oskarvh/nanoFunctionGenerator/README.md

# nanoFunctionGenerator
Arbitrary function generator using the RP2040
