oskarvh/nanoFunctionGenerator/hardware/nanoFunctionGenerator/nanoFunctionGenerator.kicad_pcb

## KiCad design hardware/nanoFunctionGenerator/nanoFunctionGenerator.kicad_pcb (2025-07-07)

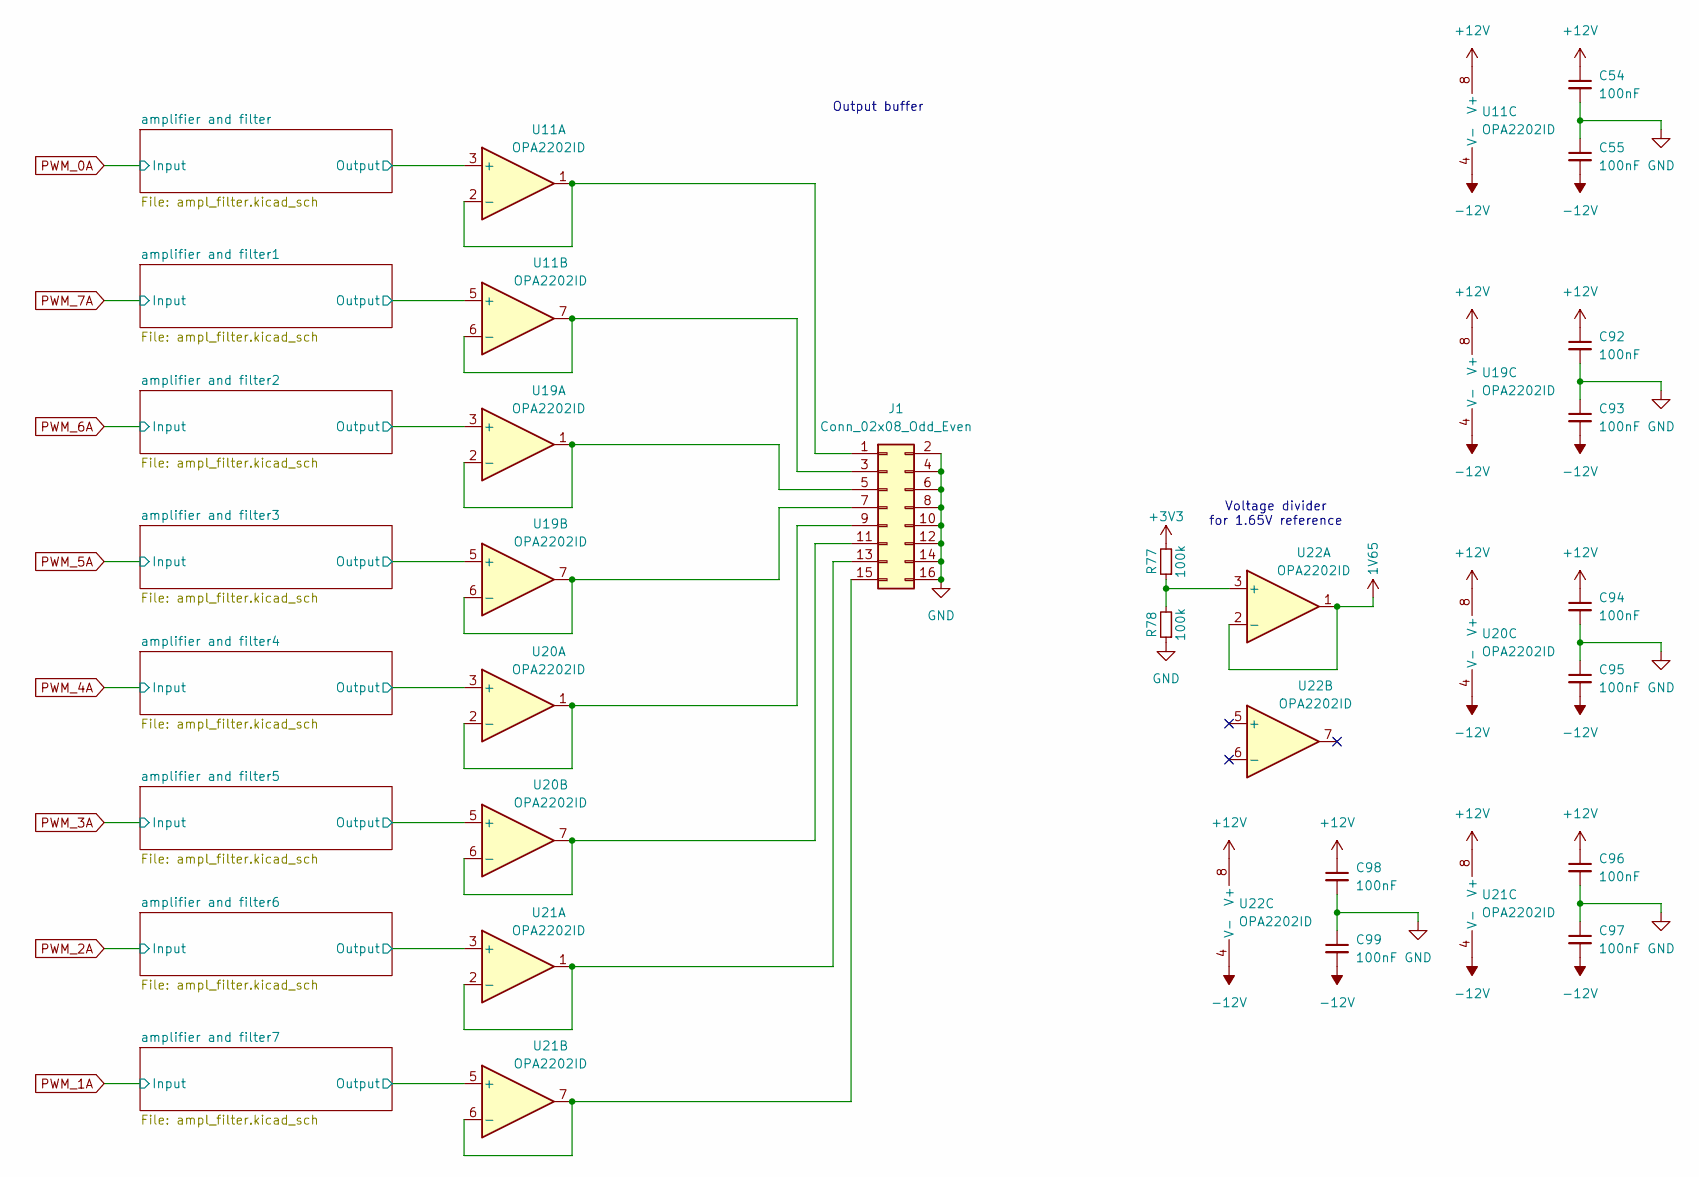
[picture p1: schematic AnalogFrontEnd.kicad_sch]

Parts:
C54, C55, C92, C93, C94, C95, C96, C97, C98, C99: 100nF; C_0402_1005Metric
J1: Conn_02x08_Odd_Even; PinHeader_2x08_P2.54mm_Vertical
R77, R78: 100k; R_0402_1005Metric
U11, U19, U20, U21, U22: OPA2202ID; SOIC-8_3.9x4.9mm_P1.27mm

Connections:
1V65: U22.1, U22.2 (-); also elsewhere on the board
+3V3: R77.2; also elsewhere on the board
+12V: C54.1, C92.1, C94.1, C96.1, C98.1, U11.8 (V+), U19.8 (V+), U20.8 (V+), U21.8 (V+), U22.8 (V+); also elsewhere on the board
-12V: C55.2, C93.2, C95.2, C97.2, C99.2, U11.4 (V-), U19.4 (V-), U20.4 (V-), U21.4 (V-), U22.4 (V-); also elsewhere on the board
/AnalogFrontEnd/amplifier and filter1/Output: U11.5 (+); also elsewhere on the board
/AnalogFrontEnd/amplifier and filter2/Output: U19.3 (+); also elsewhere on the board
/AnalogFrontEnd/amplifier and filter3/Output: U19.5 (+); also elsewhere on the board
/AnalogFrontEnd/amplifier and filter4/Output: U20.3 (+); also elsewhere on the board
/AnalogFrontEnd/amplifier and filter5/Output: U20.5 (+); also elsewhere on the board
/AnalogFrontEnd/amplifier and filter6/Output: U21.3 (+); also elsewhere on the board
/AnalogFrontEnd/amplifier and filter7/Output: U21.5 (+); also elsewhere on the board
/AnalogFrontEnd/amplifier and filter/Output: U11.3 (+); also elsewhere on the board
GND: C54.2, C55.1, C92.2, C93.1, C94.2, C95.1, C96.2, C97.1, C98.2, C99.1, J1.2, J1.4, J1.6, J1.8, J1.10, J1.12, J1.14, J1.16, R78.1; also elsewhere on the board
unnamed: J1.1, U11.1, U11.2 (-)
unnamed: J1.3, U11.6 (-), U11.7
unnamed: J1.5, U19.1, U19.2 (-)
unnamed: J1.7, U19.6 (-), U19.7
unnamed: J1.9, U20.1, U20.2 (-)
unnamed: J1.11, U20.6 (-), U20.7
unnamed: J1.13, U21.1, U21.2 (-)
unnamed: J1.15, U21.6 (-), U21.7
unnamed: R77.1, R78.2, U22.3 (+)

Notes on the sheet:
Voltage divider for 1.65V reference
Output buffer

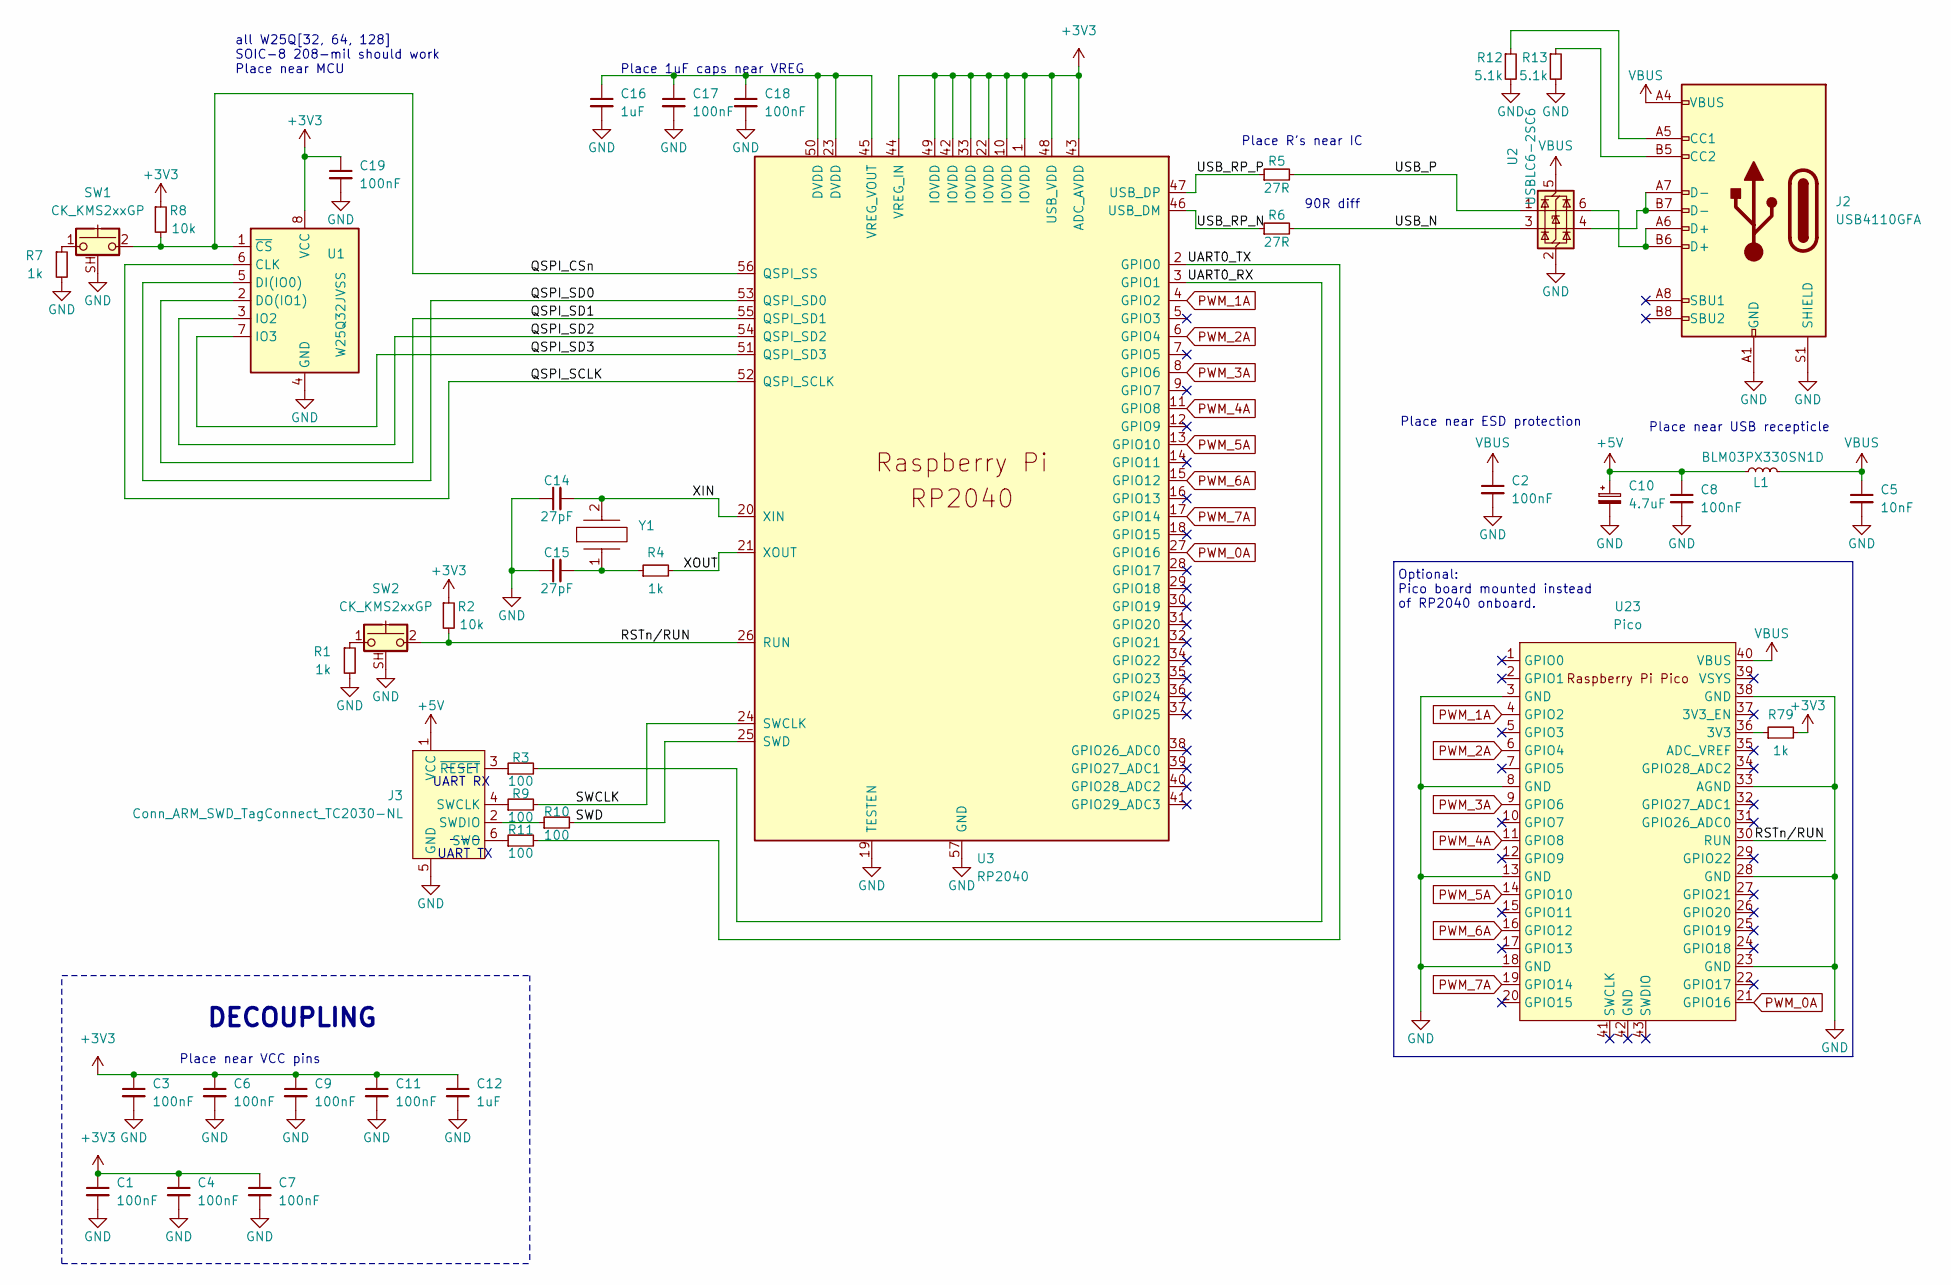
[picture p2: schematic mcu.kicad_sch]

Parts:
C1, C2, C3, C4, C6, C7, C8, C9, C11, C17, C18, C19: 100nF; C_0402_1005Metric; LCSC C1525
C5: 10nF; C_0402_1005Metric; LCSC C1525
C10: 4.7uF; C_Elec_4x5.4; Part Number 865080640004
C12, C16: 1uF; C_0402_1005Metric; LCSC C52923
C14, C15: 27pF; C_0402_1005Metric; LCSC C126504
J2: USB4110GFA; USB4110-GF-A_GCT
J3: Conn_ARM_SWD_TagConnect_TC2030-NL; Tag-Connect_TC2030-IDC-NL_2x03_P1.27mm_Vertical
L1: BLM03PX330SN1D; L_0603_1608Metric
R1, R7: 1k; R_0402_1005Metric; LCSC C279981
R2, R8: 10k; R_0402_1005Metric; LCSC C140214
R3, R9, R10, R11: 100; R_0402_1005Metric; LCSC C279981
R4, R79: 1k; R_0402_1005Metric; LCSC C11702
R5, R6: 27R; R_0402_1005Metric; LCSC C25100
R12, R13: 5.1k; R_0402_1005Metric; LCSC C279981
SW1, SW2: CK_KMS2xxGP; SW_SPST_CK_KMS2xxGP
U1: W25Q32JVSS; SOIC-8_5.23x5.23mm_P1.27mm
U2: USBLC6-2SC6; SOT-23-6
U3: RP2040; QFN-56-1EP_7x7mm_P0.4mm_EP3.2x3.2mm_ThermalVias; LCSC C2040
U23: Pico; RPi_Pico_SMD_TH
Y1: 445I23D12M00000; 445I23D12M00000_CTS-L; Mouser Part Number 774-445I23D12M00000

Connections:
+3V3: C1.1, C3.1, C4.1, C6.1, C7.1, C9.1, C11.1, C12.1, C19.1, R2.1, R8.1, R79.2, U1.8 (VCC), U3.1 (IOVDD), U3.10 (IOVDD), U3.22 (IOVDD), U3.33 (IOVDD), U3.42 (IOVDD), U3.43 (ADC_AVDD), U3.44 (VREG_IN), U3.48 (USB_VDD), U3.49 (IOVDD); also elsewhere on the board
+5V: C8.1, C10.1, J3.1 (VCC), L1.1; also elsewhere on the board
/mcu/QSPI_CSn: R8.2, SW1.2, U1.1 (~CS), U3.56 (QSPI_SS)
/mcu/QSPI_SCLK: U1.6 (CLK), U3.52 (QSPI_SCLK)
/mcu/QSPI_SD0: U1.5 (DI(IO0)), U3.53 (QSPI_SD0)
/mcu/QSPI_SD1: U1.2 (DO(IO1)), U3.55 (QSPI_SD1)
/mcu/QSPI_SD2: U1.3 (IO2), U3.54 (QSPI_SD2)
/mcu/QSPI_SD3: U1.7 (IO3), U3.51 (QSPI_SD3)
/mcu/RSTn/RUN: R2.2, SW2.2, U3.26 (RUN), U23.30 (RUN)
/mcu/SWCLK: R9.2, U3.24 (SWCLK)
/mcu/SWD: R10.2, U3.25 (SWD)
/mcu/UART0_RX: R3.2, U3.3 (GPIO1)
/mcu/UART0_TX: R11.2, U3.2 (GPIO0)
/mcu/USB_N: R6.2, U2.3 (I/O2)
/mcu/USB_P: R5.2, U2.1 (I/O1)
/mcu/USB_RP_N: R6.1, U3.46 (USB_DM)
/mcu/USB_RP_P: R5.1, U3.47 (USB_DP)
/mcu/XIN: C14.2, U3.20 (XIN), Y1.2
/mcu/XOUT: R4.2, U3.21 (XOUT)
GND: C1.2, C2.2, C3.2, C4.2, C5.2, C6.2, C7.2, C8.2, C9.2, C10.2, C11.2, C12.2, C14.1, C15.1, C16.2, C17.2, C18.2, C19.2, J2.A1 (GND), J2.A12 (GND), J2.B1 (GND), J2.B12 (GND), J2.S1 (SHIELD), J3.5 (GND), R1.2, R7.2, R12.2, R13.2, SW1.SH (B), SW2.SH (B), U1.4 (GND), U2.2 (GND), U3.19 (TESTEN), U3.57 (GND), U23.3 (GND), U23.8 (GND), U23.13 (GND), U23.18 (GND), U23.23 (GND), U23.28 (GND), U23.33 (AGND), U23.38 (GND); also elsewhere on the board
unnamed: C15.2, R4.1, Y1.1
unnamed: J2.A5 (CC1), R12.1
unnamed: J2.B5 (CC2), R13.1
unnamed: J2.A6 (D+), J2.B6 (D+), U2.6 (I/O1)
unnamed: J2.A7 (D-), J2.B7 (D-), U2.4 (I/O2)
unnamed: J3.4 (SWCLK), R9.1
unnamed: J3.2 (SWDIO), R10.1
unnamed: J3.6 (SWO), R11.1
unnamed: J3.3 (~RESET), R3.1
unnamed: R1.1, SW2.1
unnamed: R7.1, SW1.1
unnamed: C16.1, C17.1, C18.1, U3.23 (DVDD), U3.45 (VREG_VOUT), U3.50 (DVDD)
unnamed: R79.1, U23.36 (3V3)
PWM_0A: U3.27 (GPIO16), U23.21 (GPIO16); also elsewhere on the board
PWM_1A: U3.4 (GPIO2), U23.4 (GPIO2); also elsewhere on the board
PWM_2A: U3.6 (GPIO4), U23.6 (GPIO4); also elsewhere on the board
PWM_3A: U3.8 (GPIO6), U23.9 (GPIO6); also elsewhere on the board
PWM_4A: U3.11 (GPIO8), U23.11 (GPIO8); also elsewhere on the board
PWM_5A: U3.13 (GPIO10), U23.14 (GPIO10); also elsewhere on the board
PWM_6A: U3.15 (GPIO12), U23.16 (GPIO12); also elsewhere on the board
PWM_7A: U3.17 (GPIO14), U23.19 (GPIO14); also elsewhere on the board
VBUS: C2.1, C5.1, J2.A4 (VBUS), J2.A9 (VBUS), J2.B4 (VBUS), J2.B9 (VBUS), L1.2, U2.5 (VBUS), U23.40 (VBUS)

Notes on the sheet:
Place near USB recepticle
Place R's near IC
--- UART TX
Optional: Pico board mounted instead of RP2040 onboard.
--- UART RX
Place near ESD protection
all W25Q[32, 64, 128] SOIC-8 208-mil should work Place near MCU
Place 1uF caps near VREG
Place near VCC pins
90R diff
DECOUPLING

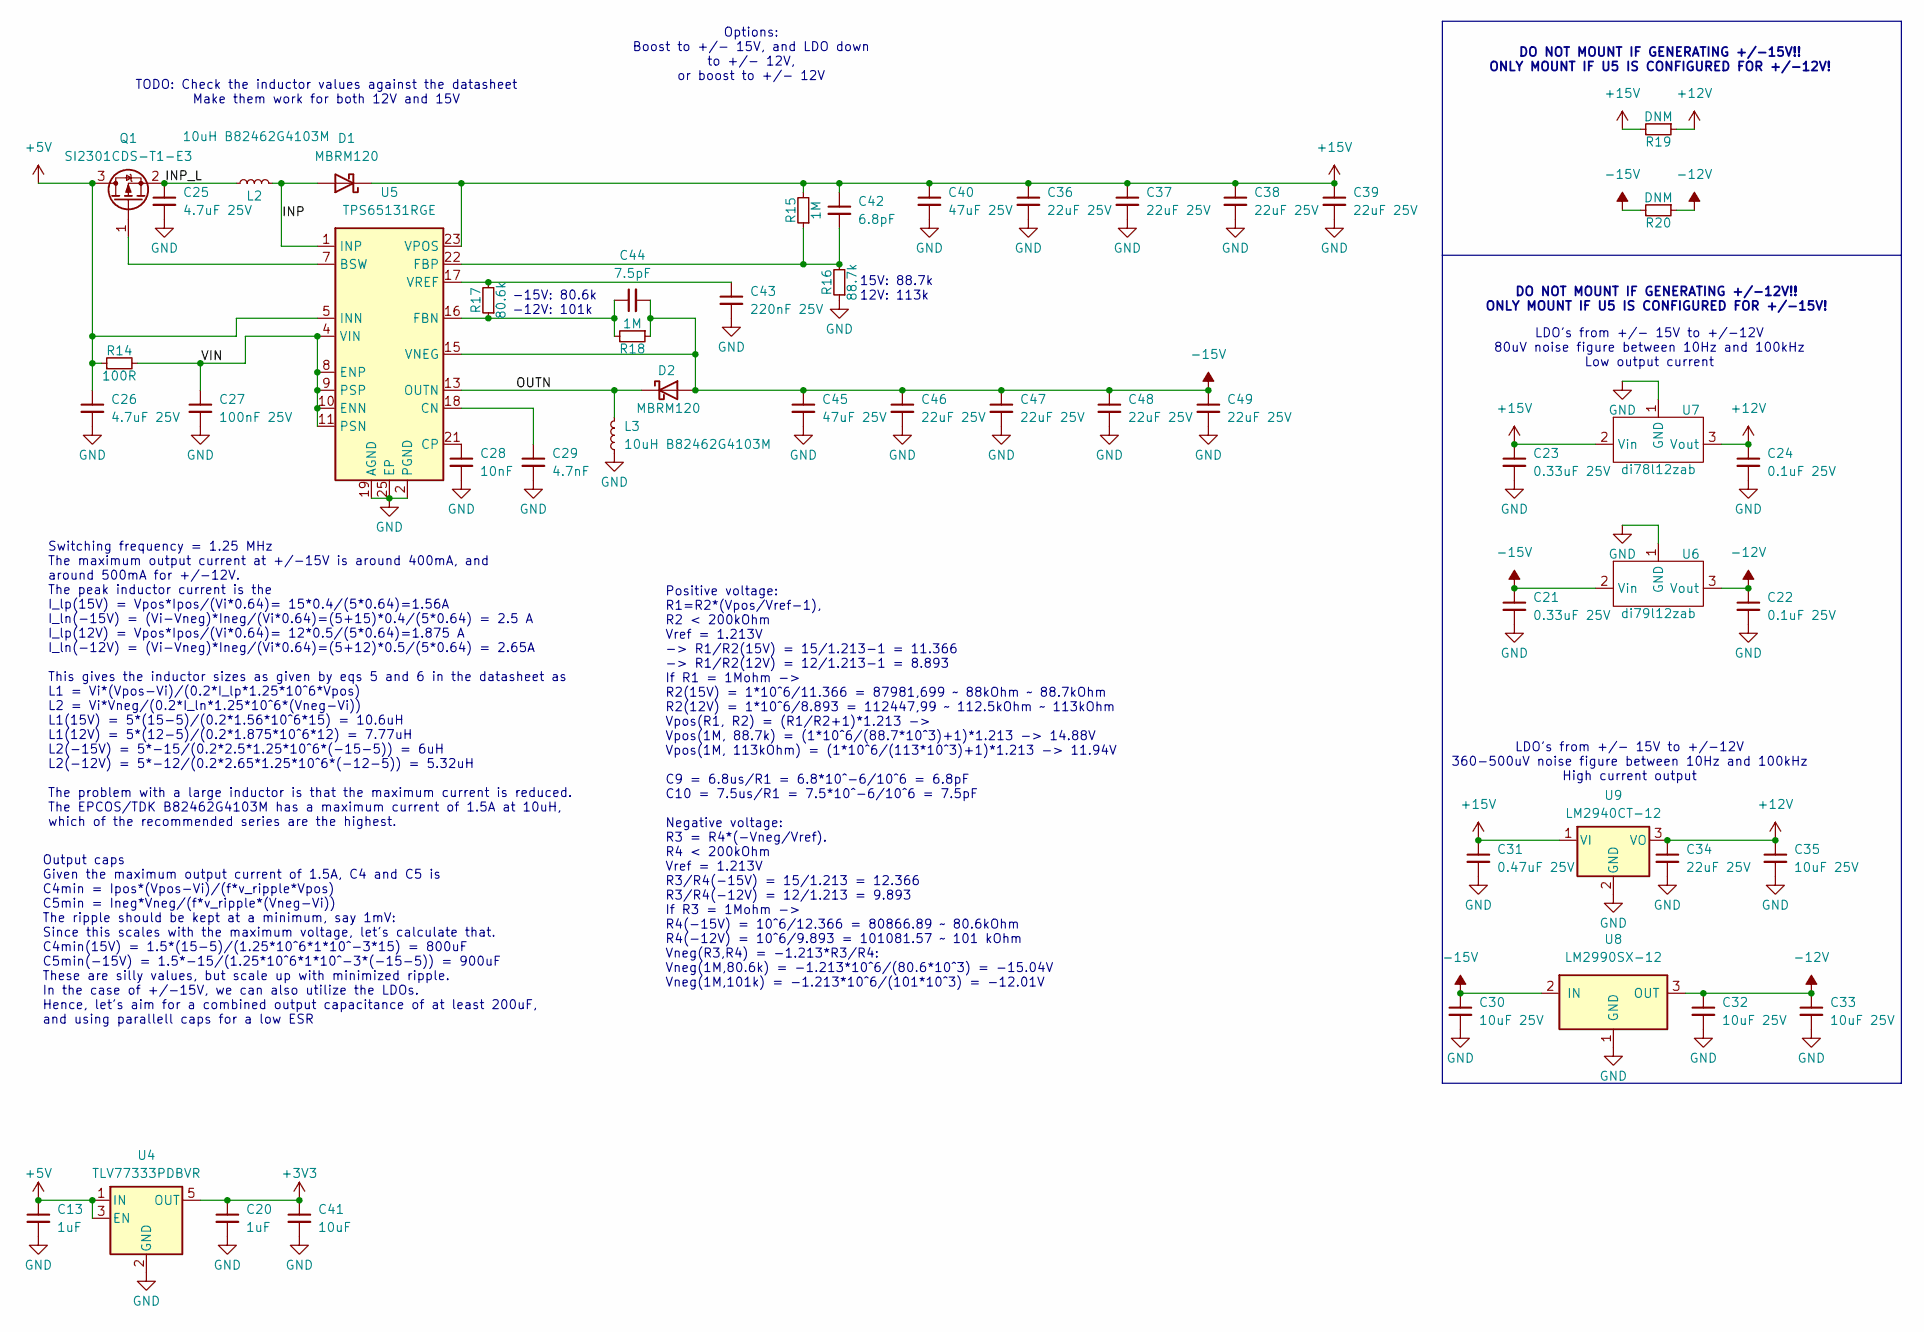
[picture p3: schematic power.kicad_sch]

Parts:
C13, C20: 1uF; C_0603_1608Metric
C21, C23: 0.33uF 25V; C_0603_1608Metric
C22, C24: 0.1uF 25V; C_0603_1608Metric
C25, C26: 4.7uF 25V; C_0805_2012Metric
C27: 100nF 25V; C_0402_1005Metric
C28: 10nF; C_0402_1005Metric
C29: 4.7nF; C_0402_1005Metric
C30, C32, C33, C35: 10uF 25V; C_0805_2012Metric
C31: 0.47uF 25V; C_0603_1608Metric
C34, C36, C37, C38, C39, C46, C47, C48, C49: 22uF 25V; C_0805_2012Metric
C40, C45: 47uF 25V; C_1206_3216Metric
C41: 10uF; C_0603_1608Metric
C42: 6.8pF; C_0402_1005Metric
C43: 220nF 25V; C_0402_1005Metric
C44: 7.5pF; C_0402_1005Metric
D1, D2: MBRM120
L2, L3: 10uH B82462G4103M; L_Vishay_IHLP-2525
Q1: SI2301CDS-T1-E3; SOT-23
R14: 100R; R_0402_1005Metric
R15, R18: 1M; R_0402_1005Metric
R16: 88.7k; R_0402_1005Metric
R17: 80.6k; R_0402_1005Metric
R19, R20: DNM; R_0402_1005Metric
U4: TLV77333PDBVR; SOT-23-5
U5: TPS65131RGE; VQFN-24-1EP_4x4mm_P0.5mm_EP2.45x2.45mm_ThermalVias
U6: di79l12zab; TO-92
U7: di78l12zab; TO-92
U8: LM2990SX-12; TO-220-3_no_hole
U9: LM2940CT-12; TO-220-3_no_hole

Connections:
+3V3: C20.1, C41.1, U4.5 (OUT); also elsewhere on the board
+5V: C13.1, C26.1, Q1.3 (D), R14.1, U4.1 (IN), U4.3 (EN), U5.5 (INN), U5.6 (INN); also elsewhere on the board
+12V: C24.1, C34.1, C35.1, R19.1, U7.3 (Vout), U9.3 (VO); also elsewhere on the board
+15V: C23.1, C31.1, C36.1, C37.1, C38.1, C39.1, C40.1, C42.1, D1.1 (K), R15.2, R19.2, U5.23 (VPOS), U7.2 (Vin), U9.1 (VI)
-12V: C22.1, C32.1, C33.1, R20.1, U6.3 (Vout), U8.3 (OUT); also elsewhere on the board
-15V: C21.1, C30.1, C44.2, C45.1, C46.1, C47.1, C48.1, C49.1, D2.2 (A), R18.1, R20.2, U5.15 (VNEG), U6.2 (Vin), U8.2 (IN)
/power/INP: D1.2 (A), L2.2, U5.1 (INP), U5.24 (INP)
/power/INP_L: C25.1, L2.1, Q1.2 (S)
/power/OUTN: D2.1 (K), L3.2, U5.13 (OUTN), U5.14 (OUTN)
/power/VIN: C27.1, R14.2, U5.4 (VIN), U5.8 (ENP), U5.9 (PSP), U5.10 (ENN), U5.11 (PSN)
GND: C13.2, C20.2, C21.2, C22.2, C23.2, C24.2, C25.2, C26.2, C27.2, C28.2, C29.2, C30.2, C31.2, C32.2, C33.2, C34.2, C35.2, C36.2, C37.2, C38.2, C39.2, C40.2, C41.2, C43.2, C45.2, C46.2, C47.2, C48.2, C49.2, L3.1, R16.1, U4.2 (GND), U5.2 (PGND), U5.3 (PGND), U5.19 (AGND), U5.25 (EP), U6.1 (GND), U7.1 (GND), U8.1 (GND), U9.2 (GND); also elsewhere on the board
unnamed: Q1.1 (G), U5.7 (BSW)
unnamed: C29.1, U5.18 (CN)
unnamed: C28.1, U5.21 (CP)
unnamed: C44.1, R17.1, R18.2, U5.16 (FBN)
unnamed: C42.2, R15.1, R16.2, U5.22 (FBP)
unnamed: C43.1, R17.2, U5.17 (VREF)

Notes on the sheet:
Switching frequency = 1.25 MHz The maximum output current at +/-15V is around 400mA, and around 500mA for +/-12V. The peak inductor current is the I_lp(15V) = Vpos*Ipos/(Vi*0.64)= 15*0.4/(5*0.64)=1.56A I_ln(-15V) = (Vi-Vneg)*Ineg/(Vi*0.64)=(5+15)*0.4/(5*0.64) = 2.5 A I_lp(12V) = Vpos*Ipos/(Vi*0.64)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
DO NOT MOUNT IF GENERATING +/-15V!! ONLY MOUNT IF U5 IS CONFIGURED FOR +/-12V!
LDO's from +/- 15V to +/-12V 80uV noise figure between 10Hz and 100kHz Low output current
Output caps Given the maximum output current of 1.5A, C4 and C5 is C4min = Ipos*(Vpos-Vi)/(f*v_ripple*Vpos) C5min = Ineg*Vneg/(f*v_ripple*(Vneg-Vi)) The ripple should be kept at a minimum, say 1mV: Since this scales with the maximum voltage, let's calculate that. C4min(15V) = 1.5*(15-5)/(1.25*10^6*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
-15V: 80.6k -12V: 101k
Positive voltage: R1=R2*(Vpos/Vref-1), R2 < 200kOhm Vref = 1.213V -> R1/R2(15V) = 15/1.213-1 = 11.366 -> R1/R2(12V) = 12/1.213-1 = 8.893 If R1 = 1Mohm -> R2(15V) = 1*10^6/11.366 = 87981,699 ~ 88kOhm ~ 88.7kOhm R2(12V) = 1*10^6/8.893 = 112447,99 ~ 112.5kOhm ~ 113kOhm Vpos(R1, R2) = (R1/R2+1)*1.213 -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
LDO's from +/- 15V to +/-12V 360-500uV noise figure between 10Hz and 100kHz High current output
DO NOT MOUNT IF GENERATING +/-12V!! ONLY MOUNT IF U5 IS CONFIGURED FOR +/-15V!
TODO: Check the inductor values against the datasheet Make them work for both 12V and 15V
Options: Boost to +/- 15V, and LDO down to +/- 12V, or boost to +/- 12V
15V: 88.7k 12V: 113k

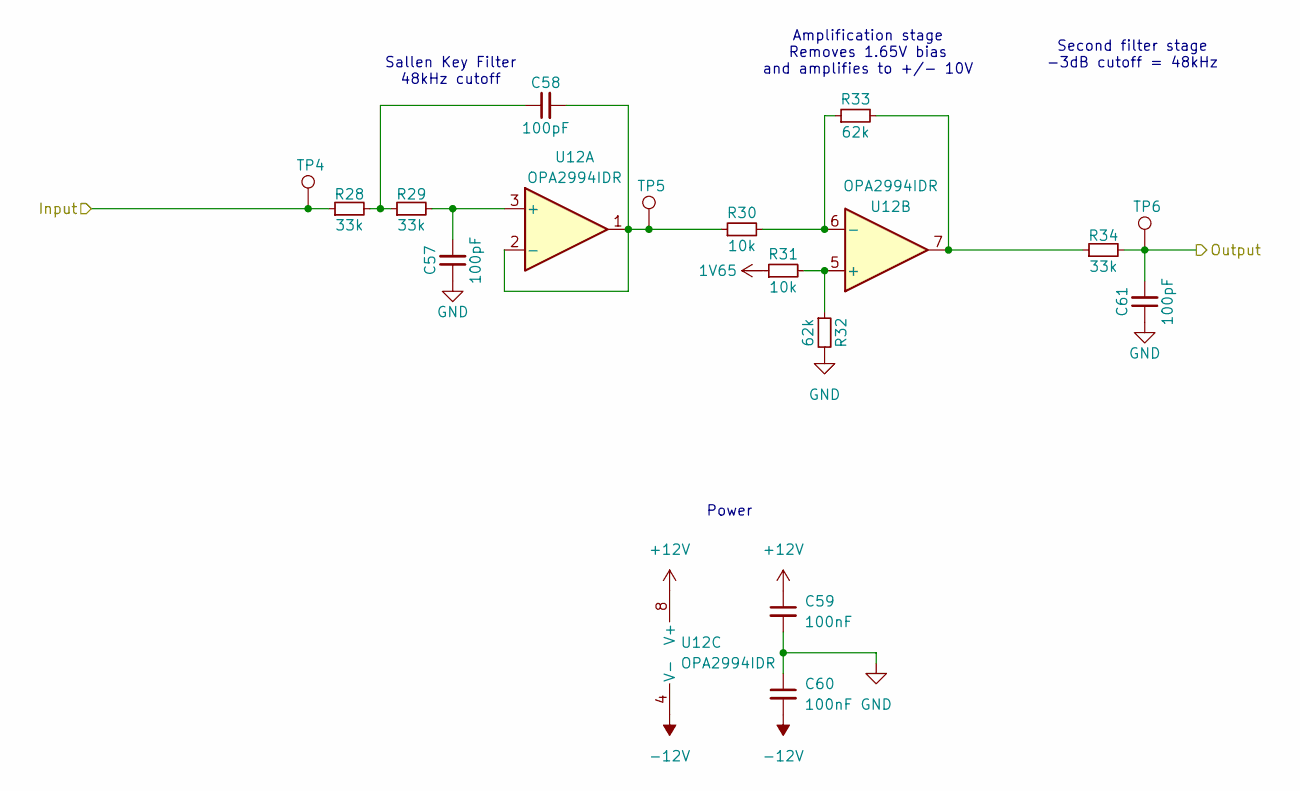
[picture p4: schematic ampl_filter.kicad_sch]

Parts:
C57, C58, C61: 100pF; C_0402_1005Metric
C59, C60: 100nF; C_0402_1005Metric
R28, R29, R34: 33k; R_0402_1005Metric
R30, R31: 10k; R_0402_1005Metric
R32, R33: 62k; R_0402_1005Metric
TP4, TP5, TP6: TestPoint; TestPoint_Pad_D1.5mm
U12: OPA2994IDR; SOIC-8_3.9x4.9mm_P1.27mm

Connections:
1V65: R31.1; also elsewhere on the board
+12V: C59.1, U12.8 (V+); also elsewhere on the board
-12V: C60.2, U12.4 (V-); also elsewhere on the board
/AnalogFrontEnd/amplifier and filter1/Output: C61.2, R34.2, TP6.1; also elsewhere on the board
GND: C57.1, C59.2, C60.1, C61.1, R32.2; also elsewhere on the board
unnamed: C58.1, R28.2, R29.1
unnamed: R33.2, R34.1, U12.7
unnamed: C57.2, R29.2, U12.3 (+)
unnamed: C58.2, R30.1, TP5.1, U12.1, U12.2 (-)
unnamed: R31.2, R32.1, U12.5 (+)
unnamed: R30.2, R33.1, U12.6 (-)
PWM_7A: R28.1, TP4.1; also elsewhere on the board

Parts of its further copies:
C50, C51, C56, C62, C63, C66, C67, C68, C71, C72, C73, C76, C77, C78, C81, C82, C83, C86, C87, C88, C91: 100pF; C_0402_1005Metric
C52, C53, C64, C65, C69, C70, C74, C75, C79, C80, C84, C85, C89, C90: 100nF; C_0402_1005Metric
R21, R22, R27, R35, R36, R41, R42, R43, R48, R49, R50, R55, R56, R57, R62, R63, R64, R69, R70, R71, R76: 33k; R_0402_1005Metric
R23, R24, R37, R38, R44, R45, R51, R52, R58, R59, R65, R66, R72, R73: 10k; R_0402_1005Metric
R25, R26, R39, R40, R46, R47, R53, R54, R60, R61, R67, R68, R74, R75: 62k; R_0402_1005Metric
TP1, TP2, TP3, TP7, TP8, TP9, TP10, TP11, TP12, TP13, TP14, TP15, TP16, TP17, TP18, TP19, TP20, TP21, TP22, TP23, TP24: TestPoint; TestPoint_Pad_D1.5mm
U10, U13, U14, U15, U16, U17, U18: OPA2994IDR; SOIC-8_3.9x4.9mm_P1.27mm

Connections of its further copies:
1V65: R24.1, R38.1, R45.1, R52.1, R59.1, R66.1, R73.1; also elsewhere on the board
+12V: C52.1, C64.1, C69.1, C74.1, C79.1, C84.1, C89.1, U10.8 (V+), U13.8 (V+), U14.8 (V+), U15.8 (V+), U16.8 (V+), U17.8 (V+), U18.8 (V+); also elsewhere on the board
-12V: C53.2, C65.2, C70.2, C75.2, C80.2, C85.2, C90.2, U10.4 (V-), U13.4 (V-), U14.4 (V-), U15.4 (V-), U16.4 (V-), U17.4 (V-), U18.4 (V-); also elsewhere on the board
/AnalogFrontEnd/amplifier and filter2/Output: C66.2, R41.2, TP9.1; also elsewhere on the board
/AnalogFrontEnd/amplifier and filter3/Output: C71.2, R48.2, TP12.1; also elsewhere on the board
/AnalogFrontEnd/amplifier and filter4/Output: C76.2, R55.2, TP15.1; also elsewhere on the board
/AnalogFrontEnd/amplifier and filter5/Output: C81.2, R62.2, TP18.1; also elsewhere on the board
/AnalogFrontEnd/amplifier and filter6/Output: C86.2, R69.2, TP21.1; also elsewhere on the board
/AnalogFrontEnd/amplifier and filter7/Output: C91.2, R76.2, TP24.1; also elsewhere on the board
/AnalogFrontEnd/amplifier and filter/Output: C56.2, R27.2, TP3.1; also elsewhere on the board
GND: C50.1, C52.2, C53.1, C56.1, C62.1, C64.2, C65.1, C66.1, C67.1, C69.2, C70.1, C71.1, C72.1, C74.2, C75.1, C76.1, C77.1, C79.2, C80.1, C81.1, C82.1, C84.2, C85.1, C86.1, C87.1, C89.2, C90.1, C91.1, R25.2, R39.2, R46.2, R53.2, R60.2, R67.2, R74.2; also elsewhere on the board
unnamed: C51.1, R21.2, R22.1
unnamed: C63.1, R35.2, R36.1
unnamed: C68.1, R42.2, R43.1
unnamed: C73.1, R49.2, R50.1
unnamed: C78.1, R56.2, R57.1
unnamed: C83.1, R63.2, R64.1
unnamed: C88.1, R70.2, R71.1
unnamed: R26.2, R27.1, U10.7
unnamed: R40.2, R41.1, U13.7
unnamed: R47.2, R48.1, U14.7
unnamed: R54.2, R55.1, U15.7
unnamed: R61.2, R62.1, U16.7
unnamed: R68.2, R69.1, U17.7
unnamed: R75.2, R76.1, U18.7
unnamed: C50.2, R22.2, U10.3 (+)
unnamed: C51.2, R23.1, TP2.1, U10.1, U10.2 (-)
unnamed: R24.2, R25.1, U10.5 (+)
unnamed: R23.2, R26.1, U10.6 (-)
unnamed: C62.2, R36.2, U13.3 (+)
unnamed: C63.2, R37.1, TP8.1, U13.1, U13.2 (-)
unnamed: R38.2, R39.1, U13.5 (+)
unnamed: R37.2, R40.1, U13.6 (-)
unnamed: C67.2, R43.2, U14.3 (+)
unnamed: C68.2, R44.1, TP11.1, U14.1, U14.2 (-)
unnamed: R45.2, R46.1, U14.5 (+)
unnamed: R44.2, R47.1, U14.6 (-)
unnamed: C72.2, R50.2, U15.3 (+)
unnamed: C73.2, R51.1, TP14.1, U15.1, U15.2 (-)
unnamed: R52.2, R53.1, U15.5 (+)
unnamed: R51.2, R54.1, U15.6 (-)
unnamed: C77.2, R57.2, U16.3 (+)
unnamed: C78.2, R58.1, TP17.1, U16.1, U16.2 (-)
unnamed: R59.2, R60.1, U16.5 (+)
unnamed: R58.2, R61.1, U16.6 (-)
unnamed: C82.2, R64.2, U17.3 (+)
unnamed: C83.2, R65.1, TP20.1, U17.1, U17.2 (-)
unnamed: R66.2, R67.1, U17.5 (+)
unnamed: R65.2, R68.1, U17.6 (-)
unnamed: C87.2, R71.2, U18.3 (+)
unnamed: C88.2, R72.1, TP23.1, U18.1, U18.2 (-)
unnamed: R73.2, R74.1, U18.5 (+)
unnamed: R72.2, R75.1, U18.6 (-)
PWM_0A: R21.1, TP1.1; also elsewhere on the board
PWM_1A: R70.1, TP22.1; also elsewhere on the board
PWM_2A: R63.1, TP19.1; also elsewhere on the board
PWM_3A: R56.1, TP16.1; also elsewhere on the board
PWM_4A: R49.1, TP13.1; also elsewhere on the board
PWM_5A: R42.1, TP10.1; also elsewhere on the board
PWM_6A: R35.1, TP7.1; also elsewhere on the board

Notes on the sheet:
Amplification stage Removes 1.65V bias and amplifies to +/- 10V
Second filter stage -3dB cutoff = 48kHz
Sallen Key Filter 48kHz cutoff
Power

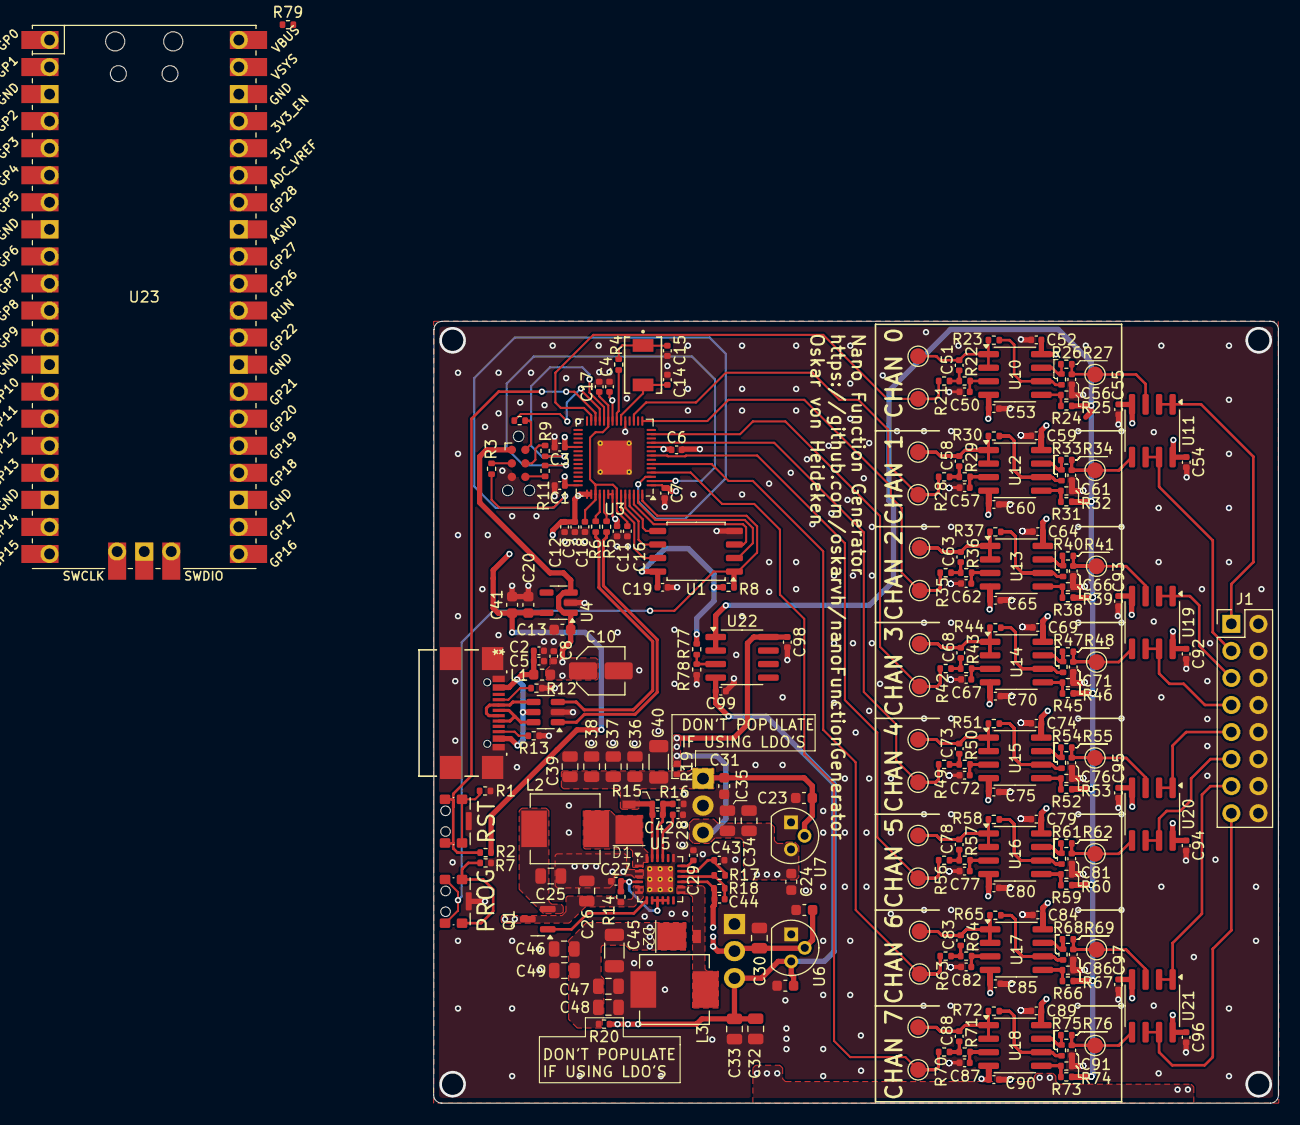
[picture p5: board nanoFunctionGenerator.kicad_pcb from above]

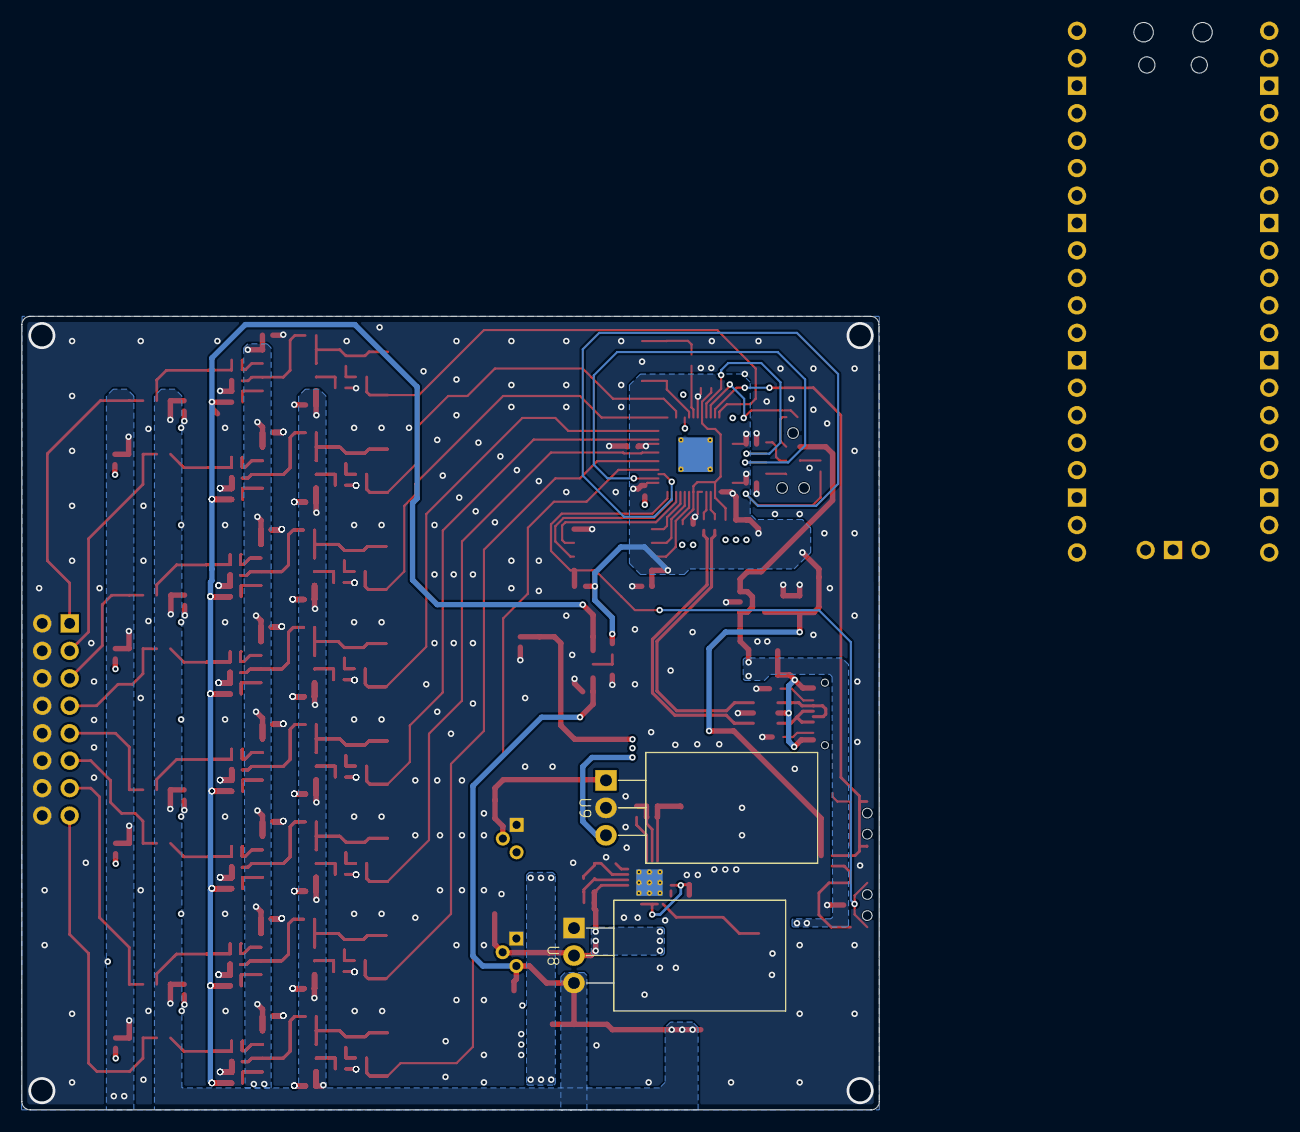
[picture p6: board nanoFunctionGenerator.kicad_pcb from below]

Board: 4 copper layers, 79.3 x 73.4 mm, 237 parts (2 on the bottom side), 122 nets.
