oskarvh/nanoFunctionGenerator/firmware/pwm_output.h

/*
MIT License

Copyright (c) 2025 Oskar von Heideken

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
THE SOFTWARE IS PROVIDED "AS IS", WITHOUT WARRANTY OF ANY KIND, EXPRESS OR
IMPLIED, INCLUDING BUT NOT LIMITED TO THE WARRANTIES OF MERCHANTABILITY,
FITNESS FOR A PARTICULAR PURPOSE AND NONINFRINGEMENT. IN NO EVENT SHALL THE
AUTHORS OR COPYRIGHT HOLDERS BE LIABLE FOR ANY CLAIM, DAMAGES OR OTHER
LIABILITY, WHETHER IN AN ACTION OF CONTRACT, TORT OR OTHERWISE, ARISING FROM,
OUT OF OR IN CONNECTION WITH THE SOFTWARE OR THE USE OR OTHER DEALINGS IN THE
SOFTWARE.
*/

#ifndef PWM_OUTPUT_H
#define PWM_OUTPUT_H
// C
#include <stdlib.h>
#include <stdint.h>

// RP2040:
#include "pico/stdlib.h"
#include "hardware/pwm.h"

// FreeRTOS
#include "FreeRTOS.h"
#include "semphr.h"
#include "queue.h"


//! defgroup PWM_output PWM Output
//! @{
//! @brief Pin mappings for the PWM output
#define NUM_PWM_CHANNELS 8
#define PWM_PIN_0A 16 // PWM channel 0A
#define PWM_PIN_1A 2  // PWM channel 1A
#define PWM_PIN_2A 4  // PWM channel 2A
#define PWM_PIN_3A 6  // PWM channel 3A
#define PWM_PIN_4A 8  // PWM channel 4A
#define PWM_PIN_5A 10 // PWM channel 5A
#define PWM_PIN_6A 12 // PWM channel 6A
#define PWM_PIN_7A 14 // PWM channel 7A
// Optional pins for the B channels of the PWM channels
#define PWM_PIN_0B 17 // PWM channel 0B
#define PWM_PIN_1B 3  // PWM channel 1B
#define PWM_PIN_2B 5  // PWM channel 2B
#define PWM_PIN_3B 7  // PWM channel 3B
#define PWM_PIN_4B 9  // PWM channel 4B
#define PWM_PIN_5B 11 // PWM channel 5B
#define PWM_PIN_6B 13 // PWM channel 6B
#define PWM_PIN_7B 15 // PWM channel 7B
//! @}

//! RP2040 PWM frequency
#define FREQ_PWM 125000000 // 125 MHz

//! Maximum number of cascaded settings
#define MAX_NUM_INCOMING_SETTINGS 10

//! Signal type configuration
typedef enum {
    SIGNAL_CONFIG_DC = 0,
    SIGNAL_CONFIG_SINE = 1,
    SIGNAL_CONFIG_TRIANGLE = 2,
    SIGNAL_CONFIG_SQUARE = 3,
    SIGNAL_CONFIG_SAW = 4,
} pwm_signal_config_t;

//! Configuration for the PWM output
typedef struct pwm_channel_config {
    uint8_t channel_num;        //!< The PWM channel to configure
    uint8_t channel_out;        //!< The channel side to configure. A or B
    pwm_signal_config_t signal_config; //!< The type of signal to generate
    uint16_t numBits;           //!< The wrap count for the PWM signal. This correponds to the number of bits.
    float frequencyHz;          //!< The frequency of the sine/triangle/square wave signal
    float dc_offset;            //!< The normalized DC offset of the sine/triangle/square wave signal
    float phase_offset;         //!< The phase offset of the sine/triangle/square wave signal in radians
    float amplitude;            //!< Normalized amplitude of the sine/triangle/square wave signal
    uint32_t slice_num;         //!< The slice number of the PWM signal
    int8_t output_channel_num;  //! Output channel in reference to the hardware. -1 means it's not connected.
    int pwm_dma_channel;        //! DMA data channel number. -1 if no DMA is used.
    int dma_ctrl_channel;       //! DMA control channel number. -1 if no DMA is used.
    bool output_enabled;        //! True if the output is enabled, false if not.
} pwm_channel_config_t;

//! Mutex to protect the configuration
extern xSemaphoreHandle PWMConfigMutex;

//! Queue for changing settings
extern QueueHandle_t pwmSettingsQueue;

//! Default configuration array of the PWM channels
extern pwm_channel_config_t pwm_config_table[NUM_PWM_CHANNELS];

//! Task for the PWM handler
//! @brief Task handler for the PWM outputs
//! @param p Unused pointer to data
void outputHandler(void *p);

#endif // PWM_OUTPUT_H
