oskarvh/nanoFunctionGenerator/(commit log)

2025-03-11 Started adding PWM outputs. They are now up and running.
2025-03-12 Added script to calculate the PWM signal
2025-03-15 Added filtering to the PWM signal to resolve the sine wave
    [sine_wave_modulation.py]
2025-03-16 PWM sine wave with DMA now works
2025-03-17 Reconfiguring the device over SCPI now works. Only DC level implemented so far, but the rest will follow shortly
    [main.c, pwm_output.c, pwm_output.h]
2025-03-17 All functions implemented, however switching function currently runs into issues.
    [main.c, pwm_output.c, pwm_output.h]
2025-03-19 Reconfig of channels now work thanks to a forum post on how to abort the DMA channels
2025-07-07 changing computers
    [AnalogFrontEnd.kicad_sch, ampl_filter.kicad_sch, mcu.kicad_sch, nanoFunctionGenerator.kicad_pcb, nanoFunctionGenerator.kicad_sch, nanoFunctionGenerator_v2.csv, nanoFunctionGenerator_v2.kicad_pcb, nanoFunctionGenerator_v2.kicad_sch]
